hugoTheClown/picollo-v2/(commit log)

2026-11-06 Initial backup: listener service, ESP32-C3 button firmware, project notes
2026-11-06 Fix AP model to TP-Link TL-WR820N and update network addresses to current 10.0.2.x subnet
    [button.ino]
2026-11-06 Add ASCII wiring diagram for the trigger button to esp32-button README
2026-11-06 Two-stage trigger (liveview then capture), status LED, photo gallery, wiring diagram
    - button.ino: button now arms liveview on 1st press, captures on 2nd,
    auto-disarms after timeout; adds a status LED (armed/capturing/idle)
    alongside the OLED
    - app.py: /liveview/start|stop|status endpoints; /capture can preempt an
    active /preview stream; /kiosk toggles between idle screen and live feed
    based on liveview state; new /gallery + /photos/<date>/<file>; threaded
    Flask server so preview streaming and other requests don't serialize
    - app.py: fix gphoto2 silently exiting 0 on a failed capture (PTP timeout)
    by also checking the output file was actually written
    - esp32-button: add a generat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
    [button.ino, generate_wiring_diagram.py]
2026-11-06 Add hardware debounce capacitor to trigger wiring; make wiring diagram English for consistency
2026-11-06 Flash the ESP32-C3 from the NUC via arduino-cli; fix USB CDC + sketch layout
    - Add esp32-button/flash.py: compiles and uploads button.ino via
    arduino-cli, auto-detects the serial port, optional --watch to stream
    serial output right after flashing
    - Move button.ino into esp32-button/button/ (Arduino requires the sketch
    folder name to match the .ino filename)
    - Fix Serial.print() producing no output on the C3's native USB port:
    needs CDCOnBoot=cdc board option, now baked into flash.py's FQBN
    - button.ino: add Serial debug logging (boot, OLED init result, Wi-Fi
    connect/retry, capture results) for easier hardware bring-up
    - Confirmed on real hardware: boots, OLED initializes correctly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
    [button.ino, flash.py]
2026-11-06 Fix WiFi connection on the ESP32-C3; move credentials out of git
    Root cause of persistent NO_AP_FOUND: SSID case mismatch (sketch had
    "Picollo", router broadcasts "picollo" lowercase) — WiFi SSIDs are
    case-sensitive. Found via a WiFi.onEvent() handler now in the firmware
    that logs the actual ESP-IDF disconnect reason code instead of just the
    generic Arduino WiFi.status(). Also added an explicit CZ country code
    (channels 1-13) since ESP-IDF's default policy can miss EU channels
    12/13 — not the actual cause here, but a real gotcha worth keeping.
    Confirmed on hardware: board connects and gets a DHCP lease.
    Moved WIFI_SSID/WIFI_PASSWORD out of button.ino into wifi_config.h,
    gitignored —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
    [button.ino, flash.py]
